S122451/backenlichten/Foto's/foto's/IMG_3767.jpg

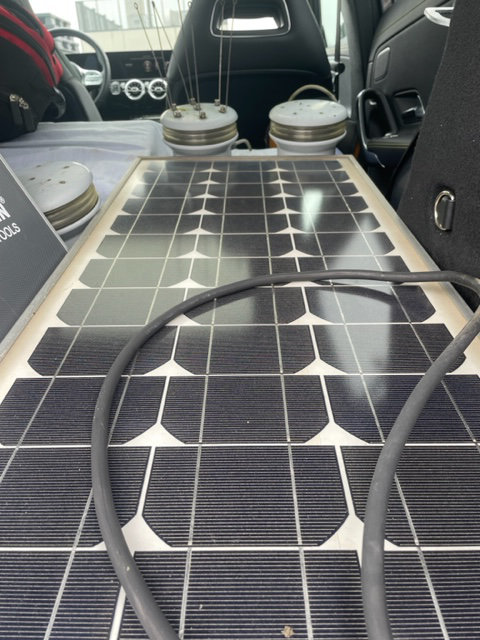
Foto's/foto's/IMG_3767.jpg
