S122451/backenlichten/Foto's/foto's/IMG_3812.jpg

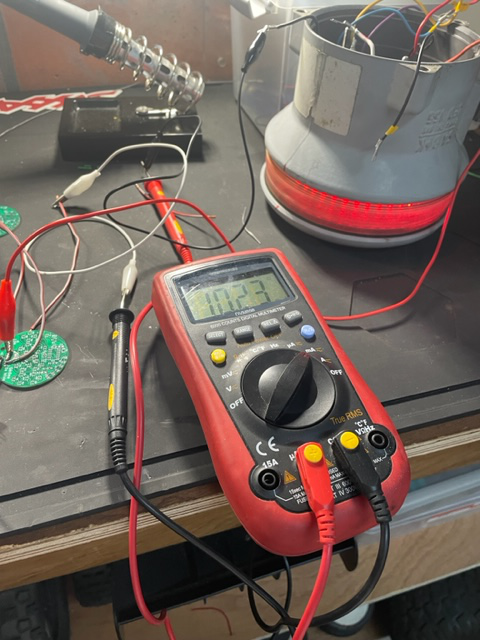
Foto's/foto's/IMG_3812.jpg
