S122451/backenlichten/Foto's/foto's/Naamloze notebook.pdf

# Power supply

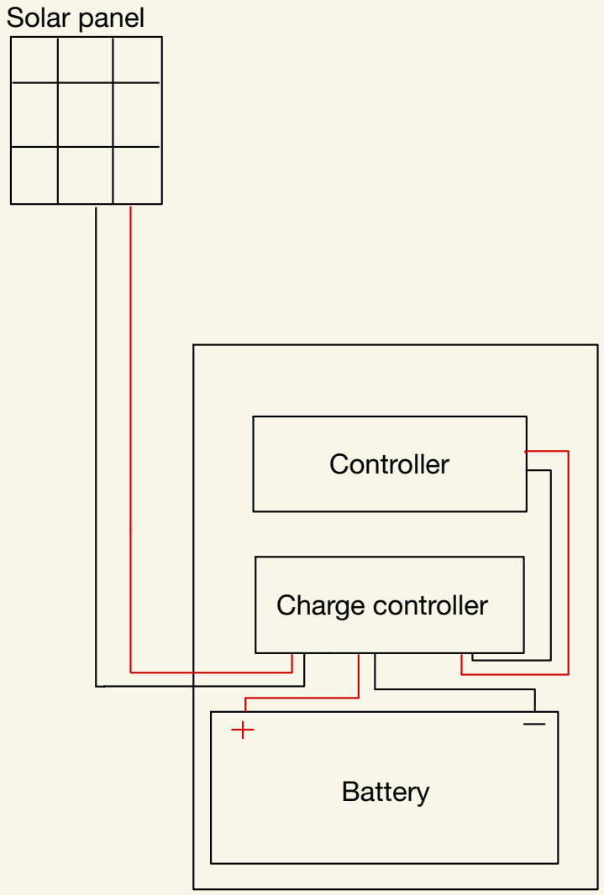
[picture p3: figure]
Controller; Charge controller; Battery; Solar panel
