S122451/backenlichten/Foto's/foto's/IMG_3604.jpg

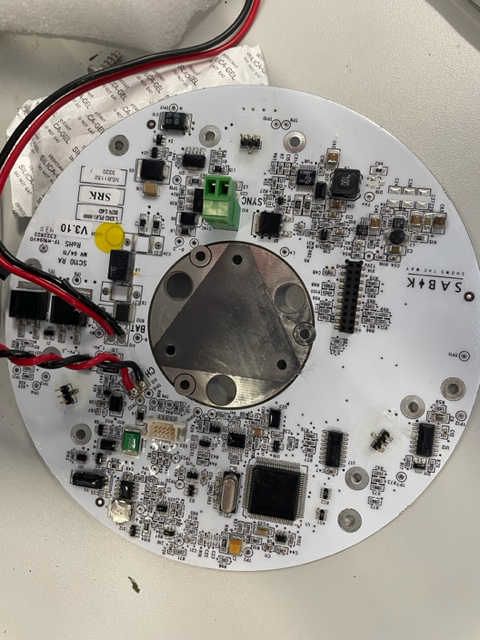
Foto's/foto's/IMG_3604.jpg
