S122451/backenlichten/Foto's/foto's/IMG_3689.jpg

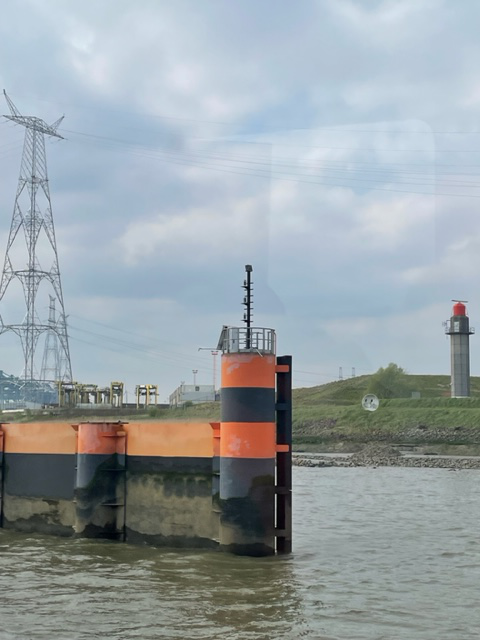
Foto's/foto's/IMG_3689.jpg
