S122451/backenlichten/Foto's/foto's/IMG_3690.jpg

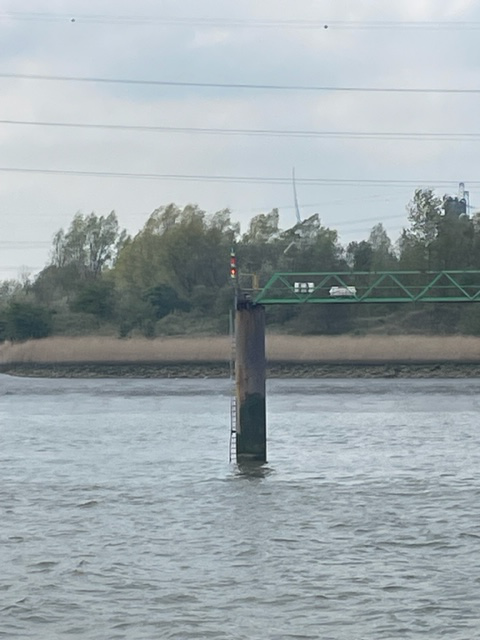
Foto's/foto's/IMG_3690.jpg
