S122451/backenlichten/Foto's/foto's/IMG_3691.jpg

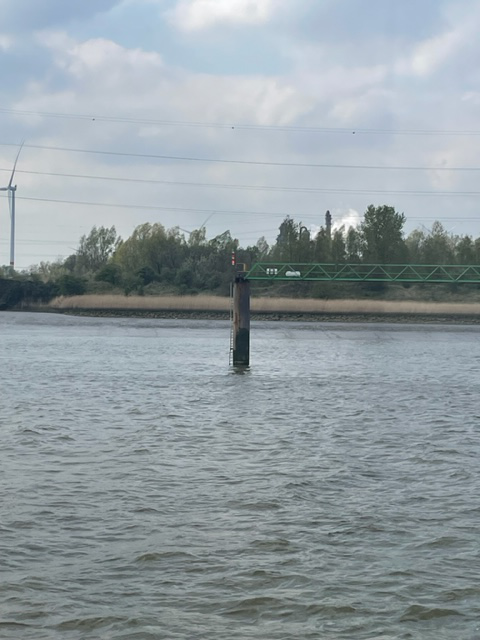
Foto's/foto's/IMG_3691.jpg
