S122451/backenlichten/Foto's/foto's/IMG_3692.jpg

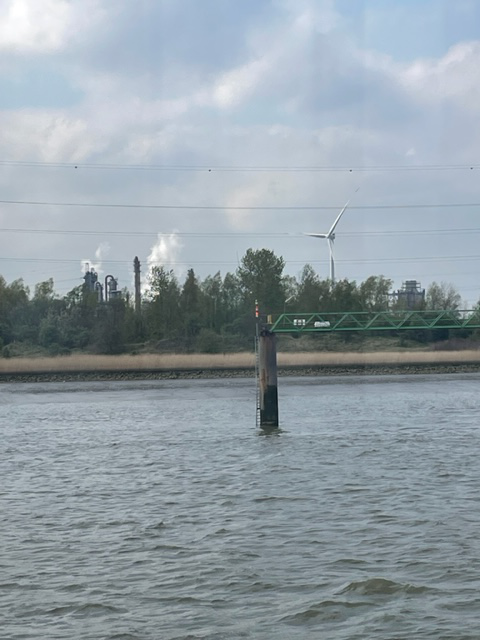
Foto's/foto's/IMG_3692.jpg
