S122451/backenlichten/Foto's/foto's/IMG_3694.jpg

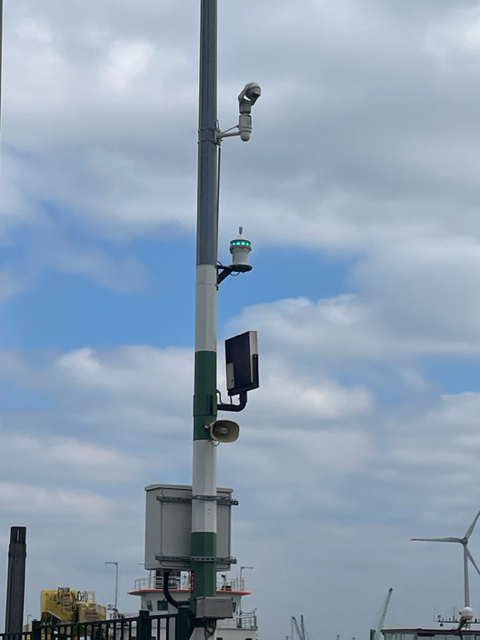
Foto's/foto's/IMG_3694.jpg
