S122451/backenlichten/Foto's/foto's/IMG_3695.jpg

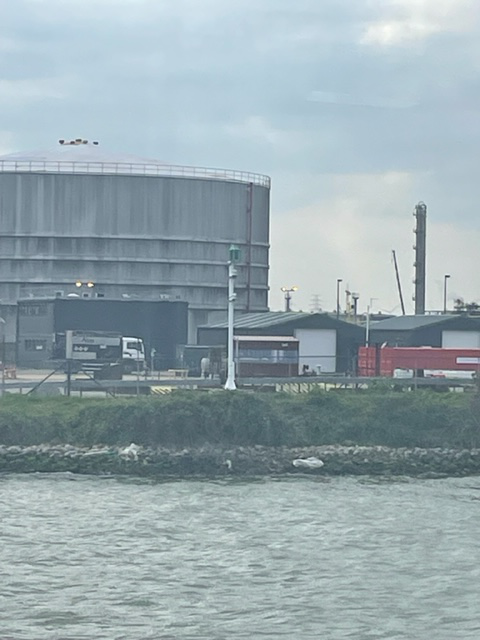
Foto's/foto's/IMG_3695.jpg
