S122451/backenlichten/Foto's/foto's/IMG_3697.jpg

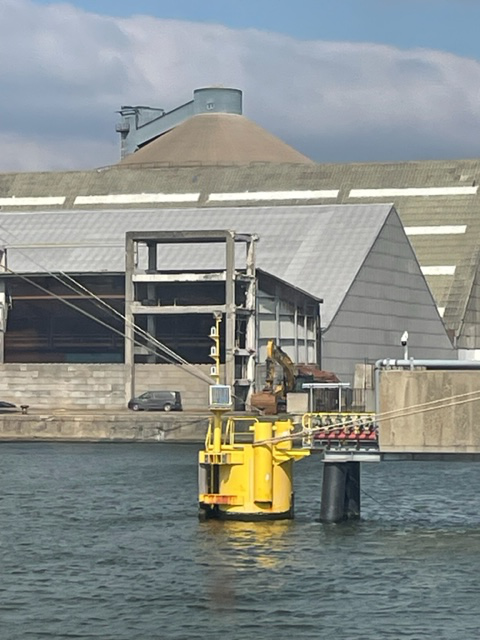
Foto's/foto's/IMG_3697.jpg
