S122451/backenlichten/Foto's/foto's/IMG_3813.jpg

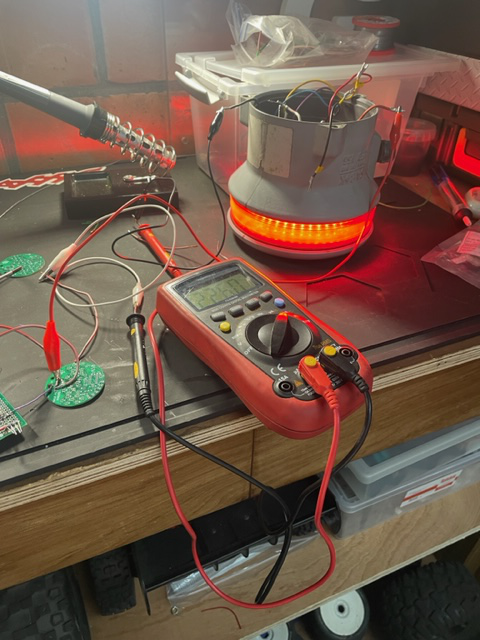
Foto's/foto's/IMG_3813.jpg
