S122451/backenlichten/Foto's/foto's/IMG_3814.jpg

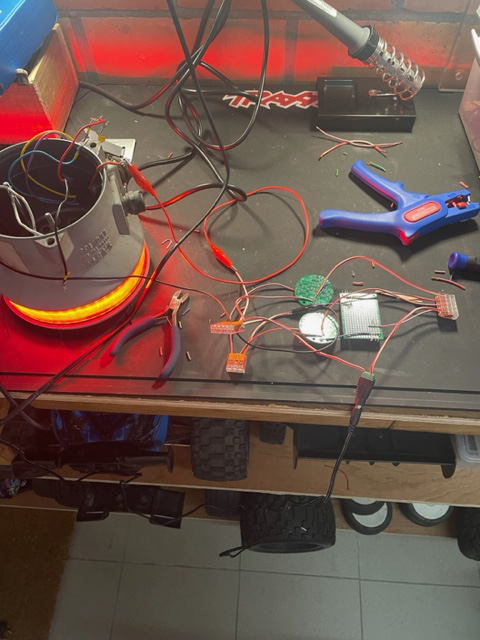
Foto's/foto's/IMG_3814.jpg
