S122451/backenlichten/Foto's/foto's/IMG_3815.jpg

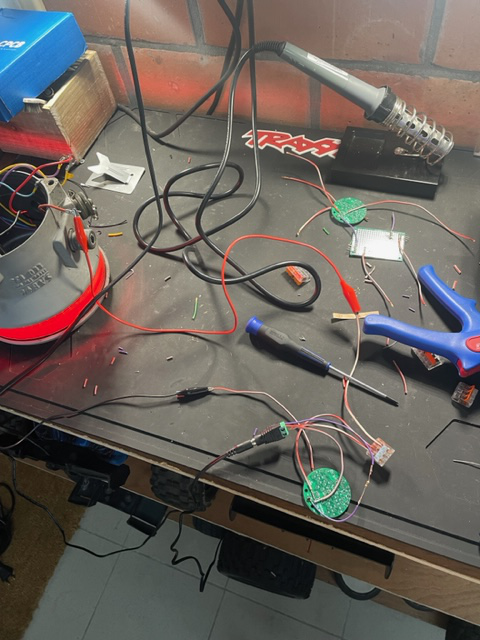
Foto's/foto's/IMG_3815.jpg
