S122451/backenlichten/Foto's/foto's/IMG_3816.jpg

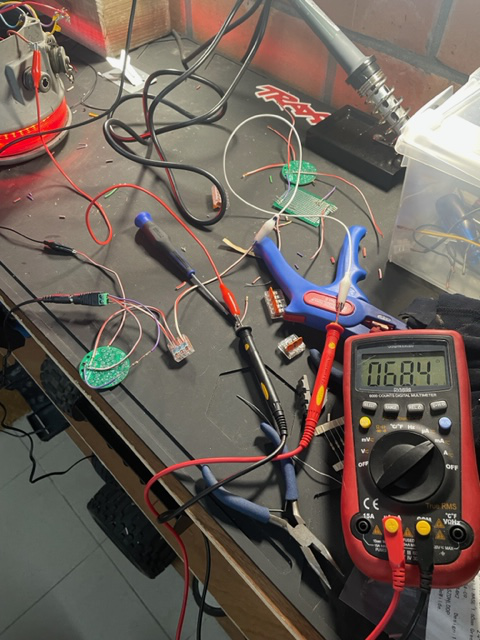
Foto's/foto's/IMG_3816.jpg
