S122451/backenlichten/Foto's/foto's/IMG_3817.jpg

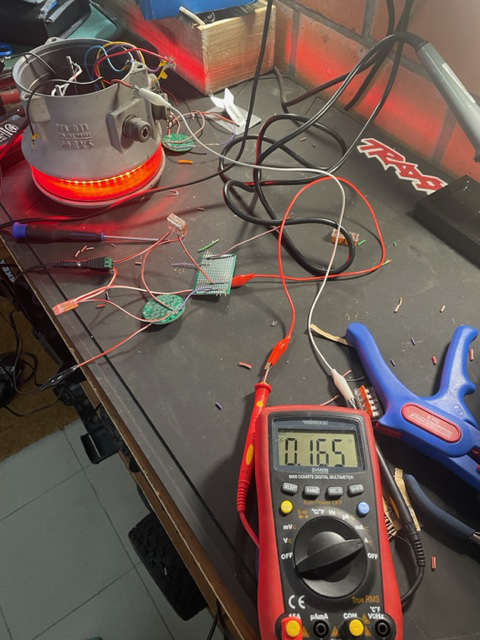
Foto's/foto's/IMG_3817.jpg
