S122451/backenlichten/Foto's/foto's/IMG_3842.jpg

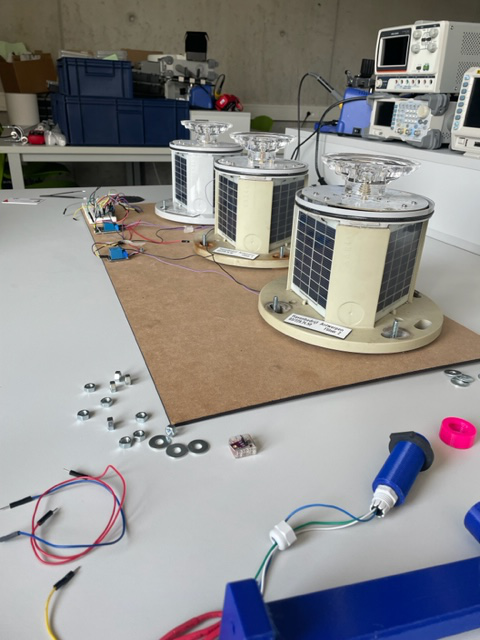
Foto's/foto's/IMG_3842.jpg
