S122451/backenlichten/Foto's/foto's/IMG_3871.jpg

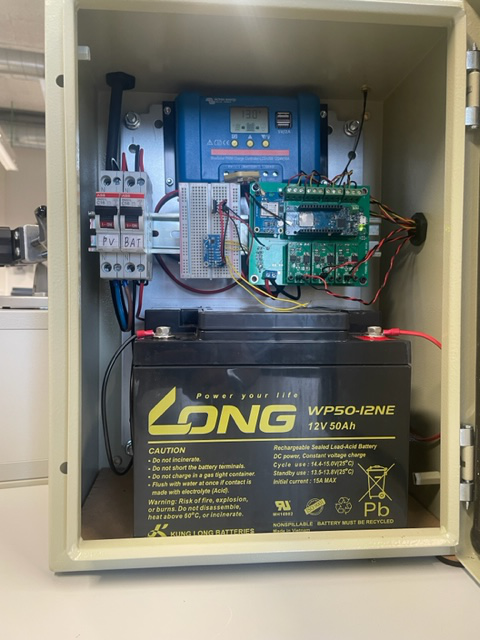
Foto's/foto's/IMG_3871.jpg
