S122451/backenlichten/Foto's/foto's/IMG_3872.jpg

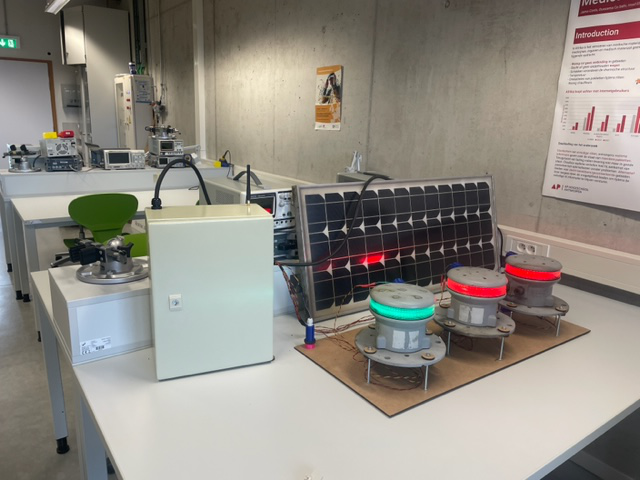
Foto's/foto's/IMG_3872.jpg
